bencz/z8086/(list of files, drawings)

Other design files:
config/asic/nangate45/FreePDK45_2000.lyt
