bencz/z8086/tests/sim_main.cpp

#include <verilated.h>
#include <verilated_fst_c.h>
#include <cstdint>
#include "Vtb_z8086.h"

int main(int argc, char** argv) {
    auto contextp = new VerilatedContext;
    contextp->commandArgs(argc, argv);
    bool trace = false;
    for (int i = 1; i < argc; ++i) {
        if (std::string(argv[i]) == "+trace") trace = true;
    }
    contextp->traceEverOn(trace);
    auto top = new Vtb_z8086{contextp};
    VerilatedFstC* tfp = nullptr;
    if (trace) {
        tfp = new VerilatedFstC;
        top->trace(tfp, 99);
        tfp->open("wave.fst");
    }

    // Parse a simple cycle limit from args: --cycles=N or +cycles=N or +max_cycles=N
    vluint64_t max_cycles = 100; // default
    for (int i = 1; i < argc; ++i) {
        std::string a(argv[i]);
        auto pos = a.find("=");
        if (pos != std::string::npos) {
            auto k = a.substr(0, pos);
            auto v = a.substr(pos + 1);
            if (k == "+cycles") {
                max_cycles = std::stoull(v);
                printf("Setting max_cycles to %llu\n",
                       static_cast<unsigned long long>(max_cycles));
            }
        }
    }

    const vluint64_t max_ticks = max_cycles * 10;
    vluint64_t ticks = 0;
    while (!contextp->gotFinish() && ticks < max_ticks) {
        top->eval();
        if (tfp) tfp->dump(contextp->time());
        contextp->timeInc(1);
        ++ticks;
    }

    if (tfp) {
        tfp->close();
        delete tfp;
    }

    delete top;
    delete contextp;
    return 0;
}
