bencz/z8086/(commit log)

2026-08-26 asic: organize CPU floorplan and generate readable final die view
    - partition ROM, decoder, control, registers, ALU and BIU regions
    - complete warning-free Nangate45 routing and signoff
    - achieve zero DRC, antenna, timing and electrical violations
    - generate annotated die image directly from final GDS and ODB
    - prevent redundant rerouting during tapeout finish
    - update ASIC metrics and documentation
    [FreePDK45_2000.lyt]
2026-08-26 docs: add missing logic-only die capture
